BioARTS-Lab/Miniature_Microscope/Supporting Information/S6_Fig.tif

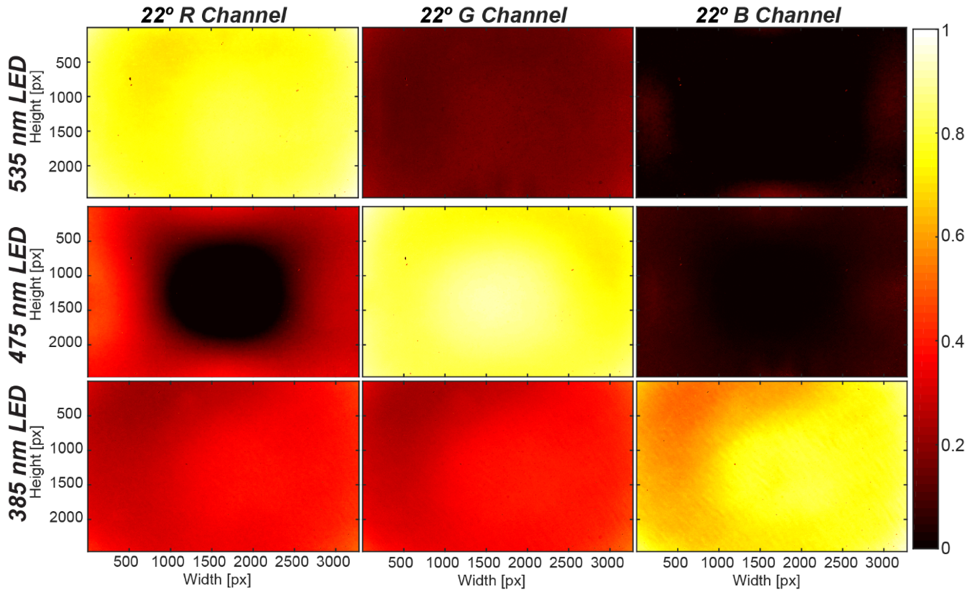
Supporting Information/S6_Fig.tif
