BioARTS-Lab/Miniature_Microscope/Supporting Information/S5_Fig.tif

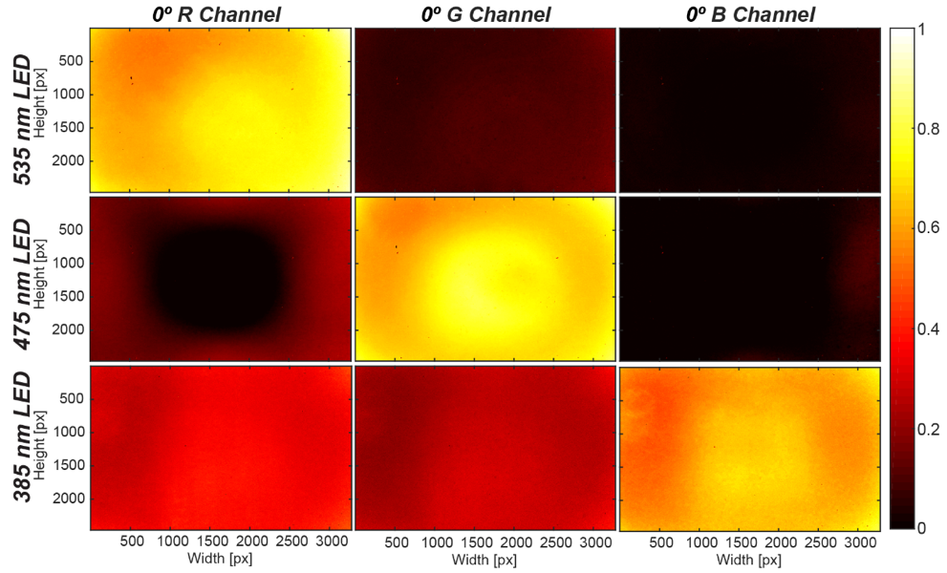
Supporting Information/S5_Fig.tif
