BioARTS-Lab/Miniature_Microscope/README.md

# Miniture_Microscope
3D-printed fluorescence miniature microscope
