BioARTS-Lab/Miniature_Microscope/GUI Python Script/start.gif

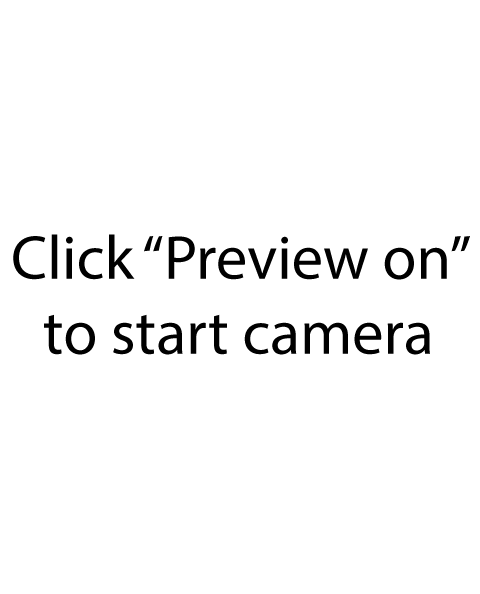
GUI Python Script/start.gif
