BioARTS-Lab/Miniature_Microscope/PCB Design Files - KiCAD/LEDs PCB.png

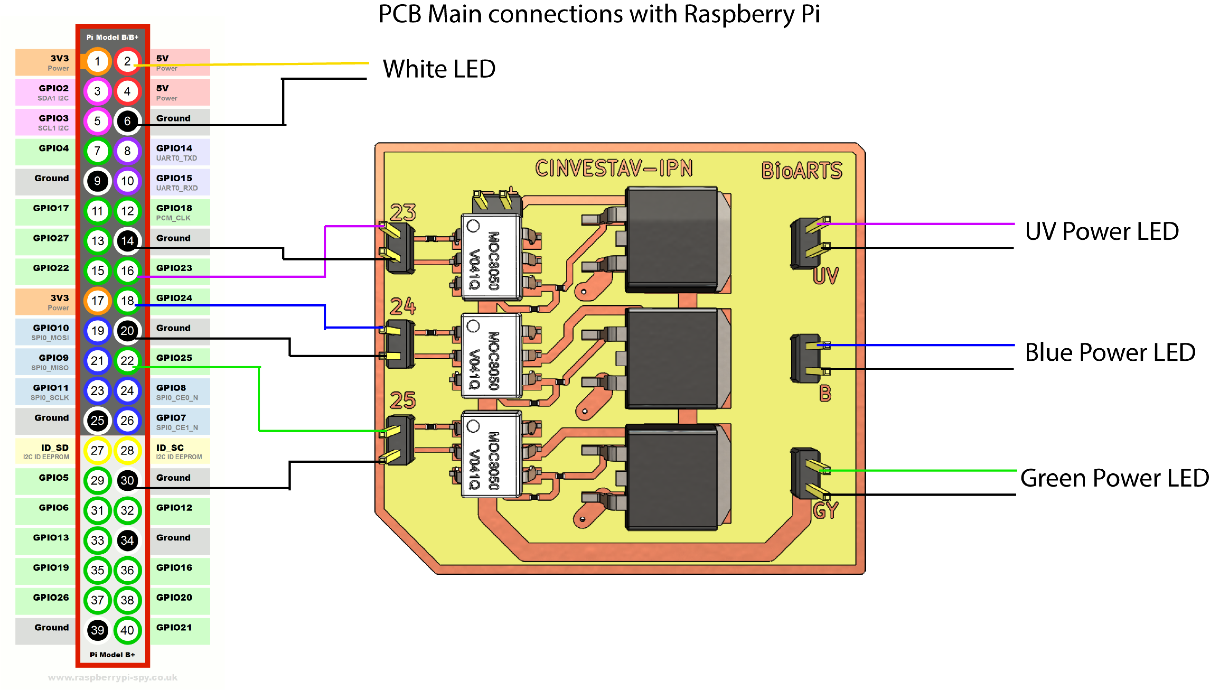
PCB Design Files - KiCAD/LEDs PCB.png
