BioARTS-Lab/Miniature_Microscope/Supporting Information/S1_Fig.tif

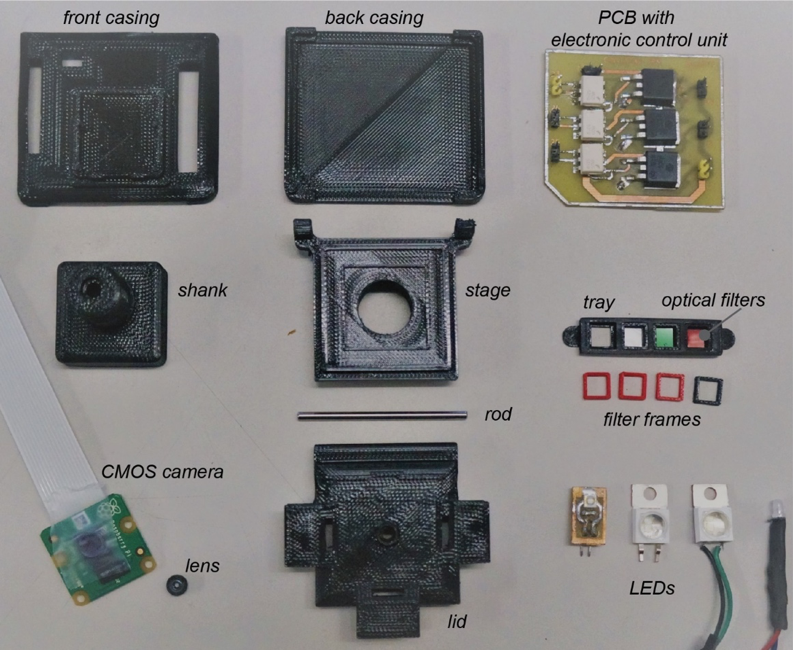
Supporting Information/S1_Fig.tif
