BioARTS-Lab/Miniature_Microscope/Supporting Information/S2_Fig.tif

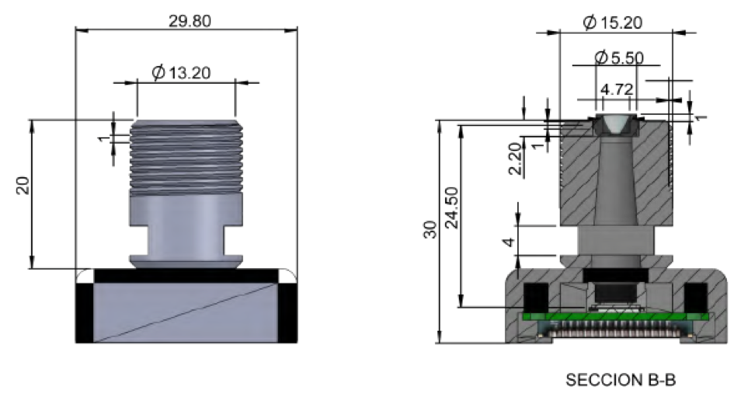
Supporting Information/S2_Fig.tif
