BioARTS-Lab/Miniature_Microscope/Supporting Information/S3_Fig.tif

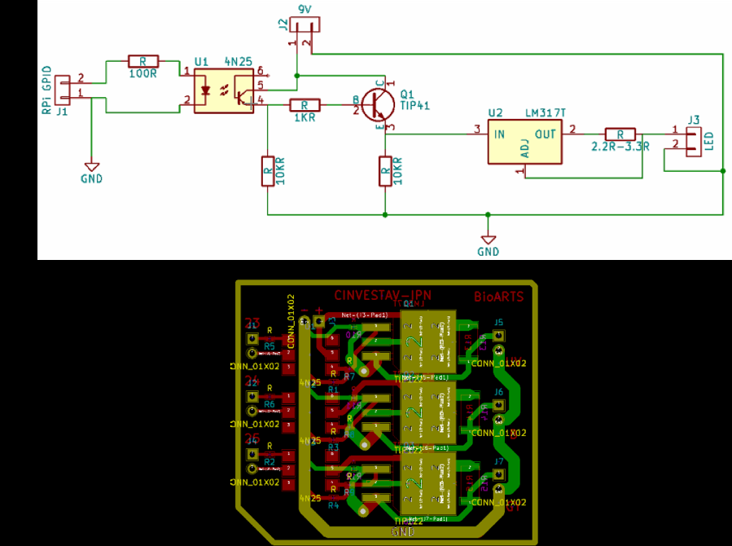
Supporting Information/S3_Fig.tif
