BioARTS-Lab/Miniature_Microscope/Supporting Information/S4_Fig.tif

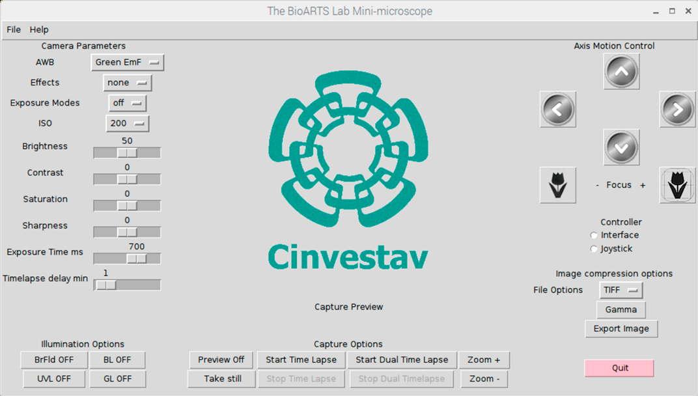
Supporting Information/S4_Fig.tif
