BioARTS-Lab/Miniature_Microscope/Supporting Information/S7_Fig.tif

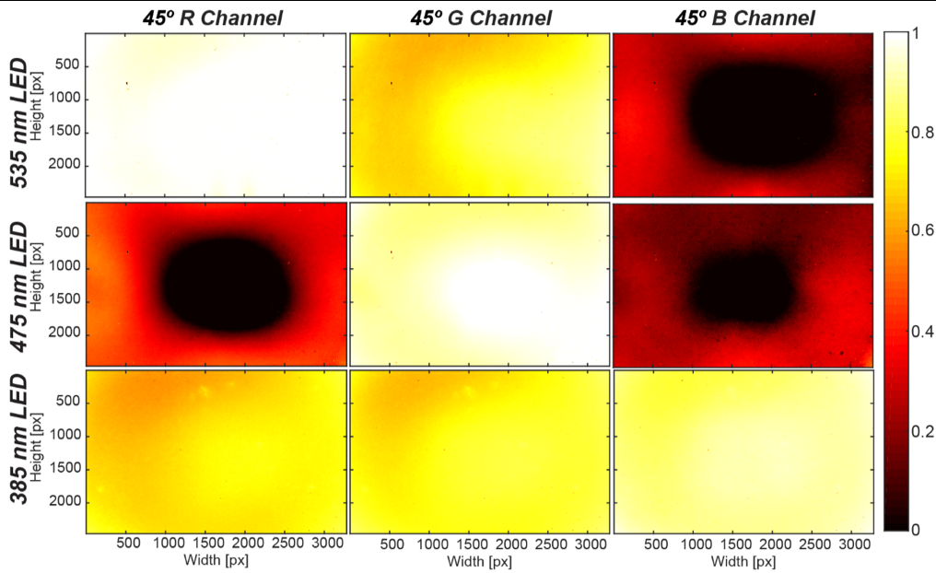
Supporting Information/S7_Fig.tif
