BioARTS-Lab/Miniature_Microscope/Supporting Information/S8_Fig.tif

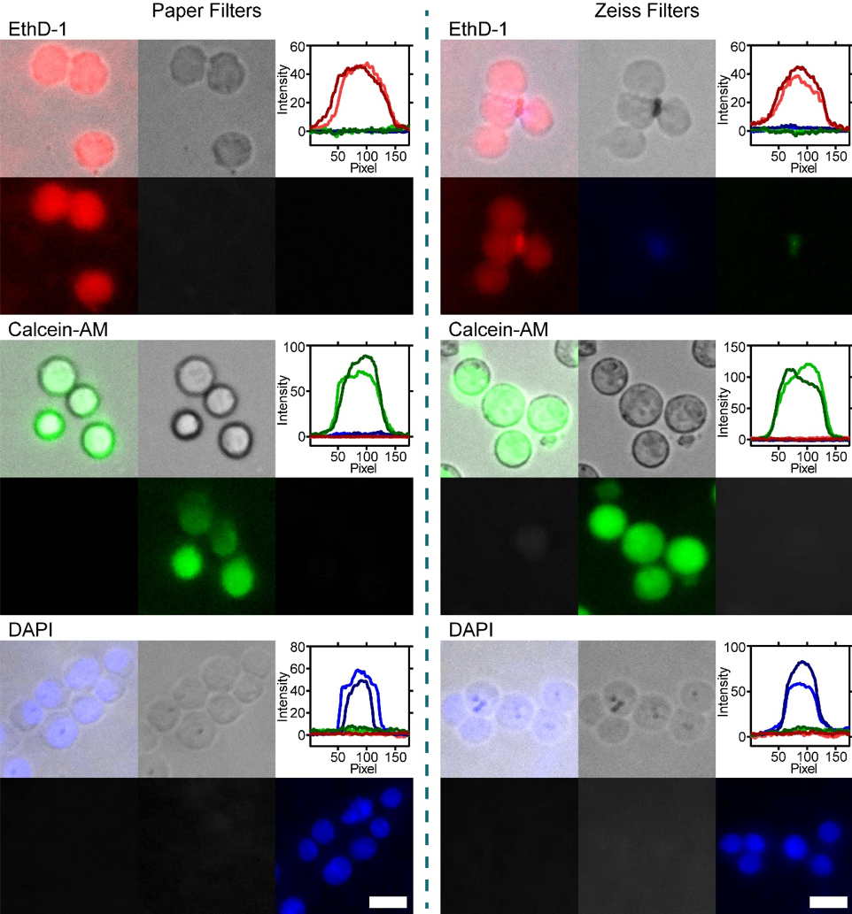
Supporting Information/S8_Fig.tif
