BioARTS-Lab/Miniature_Microscope/Supporting Information/S9_Fig.tif

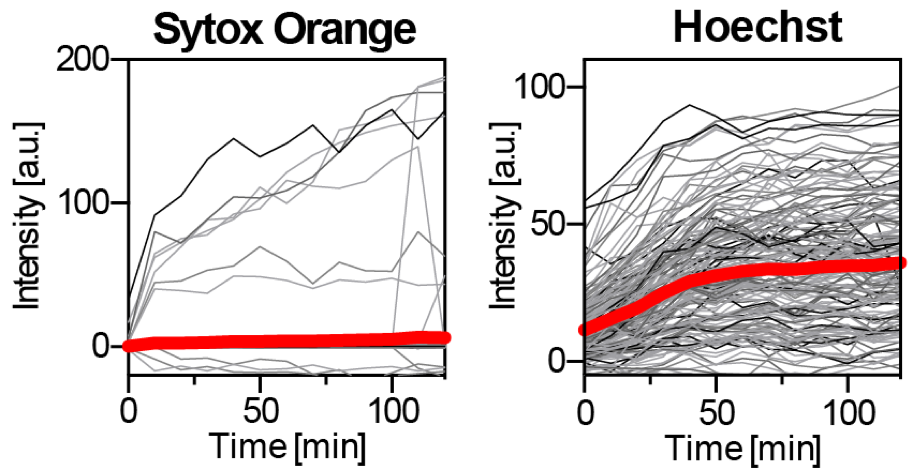
Supporting Information/S9_Fig.tif
