BioARTS-Lab/Miniature_Microscope/Supporting Information/S10_Fig.tif

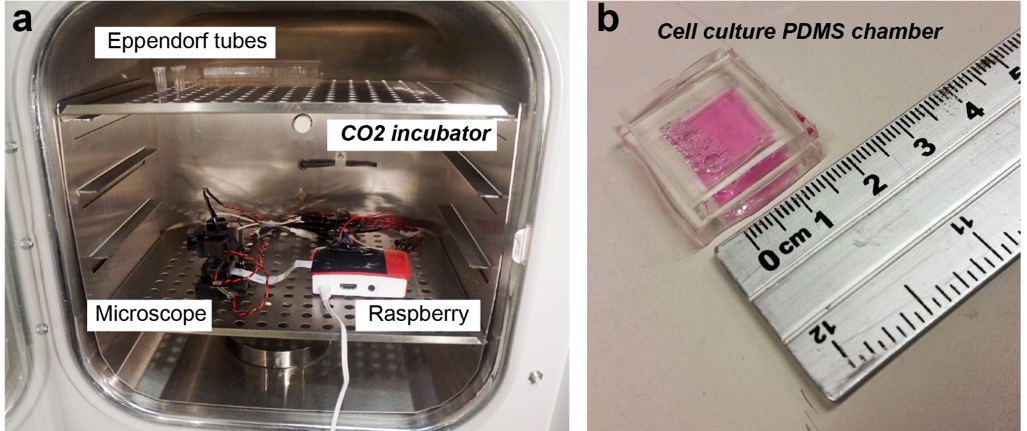
Supporting Information/S10_Fig.tif
