BioARTS-Lab/Miniature_Microscope/3D STL Files/LEDDrivePCB-Enclosure-CameraBase.STL

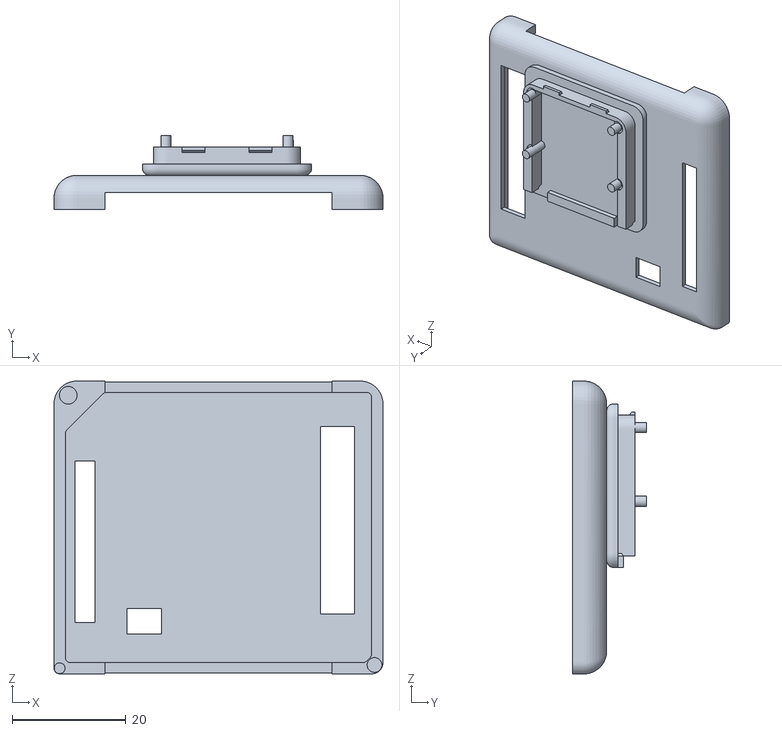
[picture p13: CAD file, 2019-08-25]
3D STL Files/LEDDrivePCB-Enclosure-CameraBase.STL
57.9 x 13.0 x 51.5
