BioARTS-Lab/Miniature_Microscope/PCB Design Files - KiCAD/LEDs PCB/LEDControlPCBSMDV2-Back Path_Cu.dxf

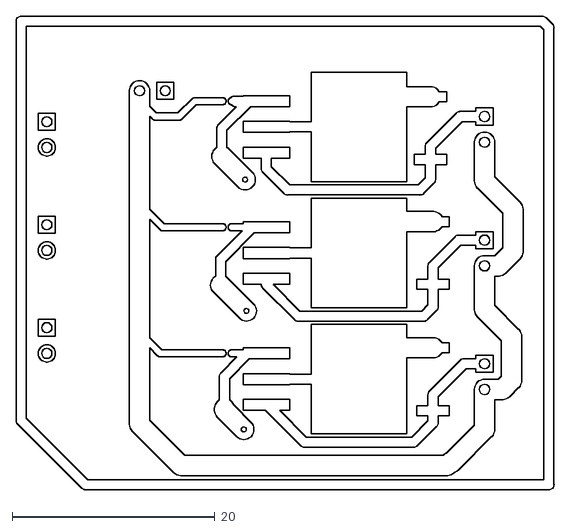
[picture p14: CAD file, 2019-08-25]
PCB Design Files - KiCAD/LEDs PCB/LEDControlPCBSMDV2-Back Path_Cu.dxf
53.1 x 46.7
