BioARTS-Lab/Miniature_Microscope/PCB Design Files - KiCAD/UV-LED PCB/UV LED PCB Layout-Front path_Cu.dxf

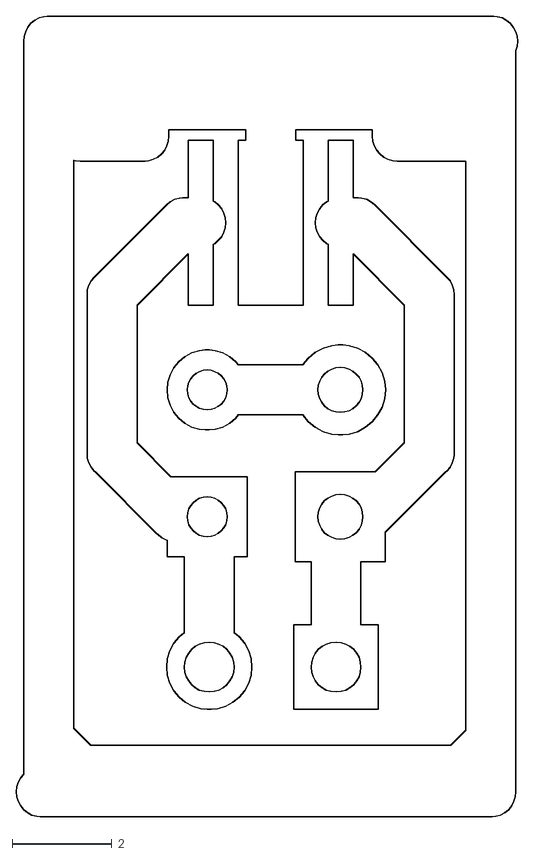
[picture p15: CAD file, 2019-08-25]
PCB Design Files - KiCAD/UV-LED PCB/UV LED PCB Layout-Front path_Cu.dxf
10.0 x 16.0
