BioARTS-Lab/Miniature_Microscope/3D STL Files/LEDDrivePCB-Base.STL

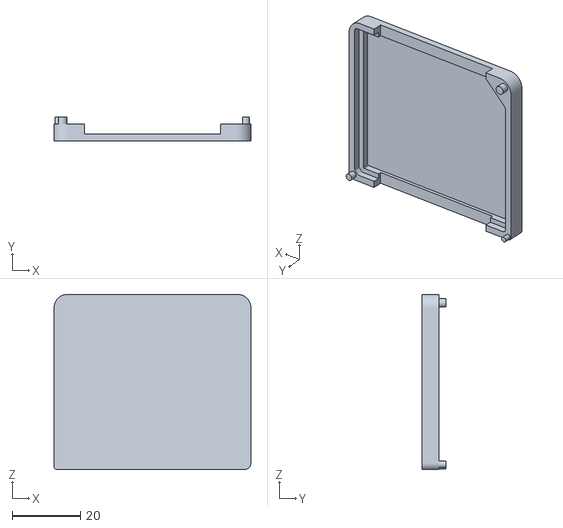
[picture p16: CAD file, 2019-08-25]
3D STL Files/LEDDrivePCB-Base.STL
57.9 x 7.00 x 51.5
