BioARTS-Lab/Miniature_Microscope/PCB Design Files - KiCAD/LEDs PCB/LEDControlPCBSMDV2-Back Path_CuMirror.dxf

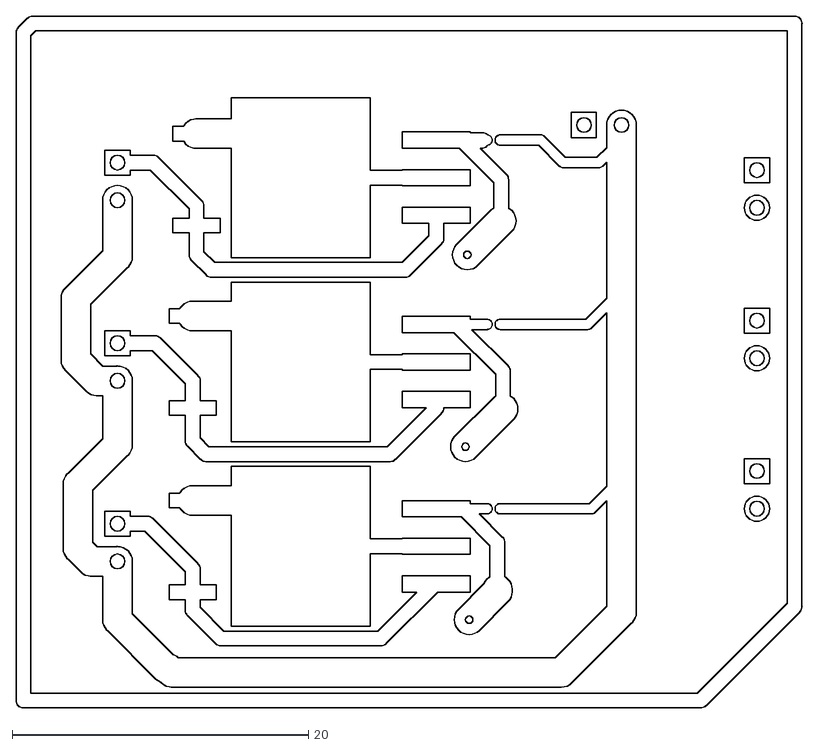
[picture p17: CAD file, 2019-08-25]
PCB Design Files - KiCAD/LEDs PCB/LEDControlPCBSMDV2-Back Path_CuMirror.dxf
53.1 x 46.7
