BioARTS-Lab/Miniature_Microscope/PCB Design Files - KiCAD/UV-LED PCB/solderLED-Footprint.DXF

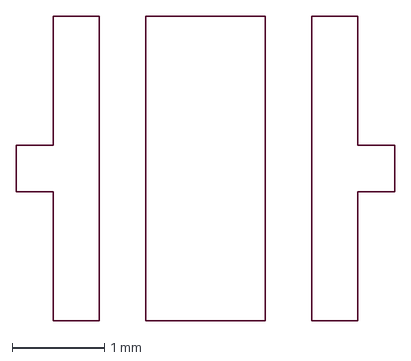
[picture p18: CAD file, 2019-08-25]
PCB Design Files - KiCAD/UV-LED PCB/solderLED-Footprint.DXF
4.10 x 3.30 mm
