BioARTS-Lab/Miniature_Microscope/3D STL Files/Plate.STL

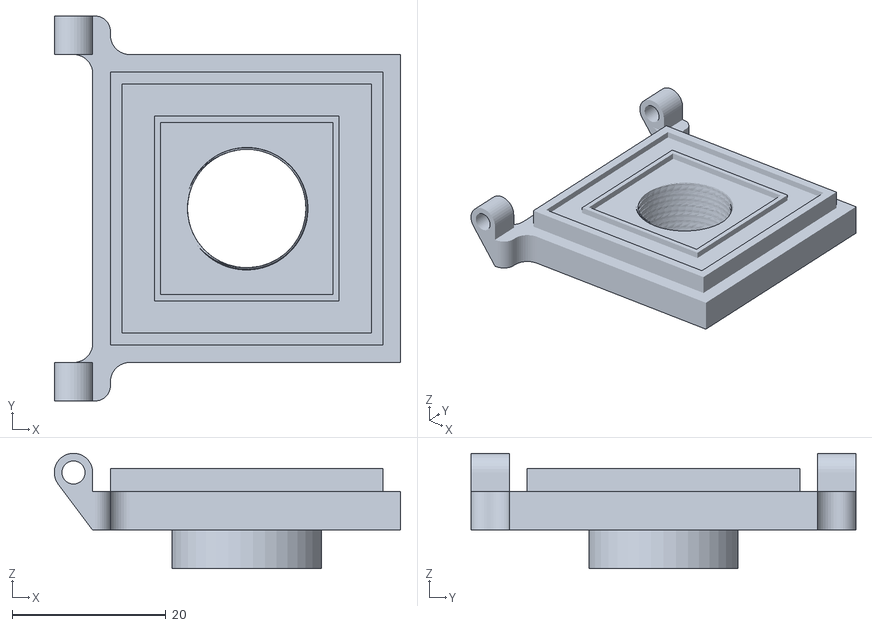
[picture p19: CAD file, 2019-08-25]
3D STL Files/Plate.STL
45.0 x 50.0 x 15.0
