BioARTS-Lab/Miniature_Microscope/PCB Design Files - KiCAD/LEDs PCB/LEDControlPCBSMDV2-Front paths_Cu.dxf

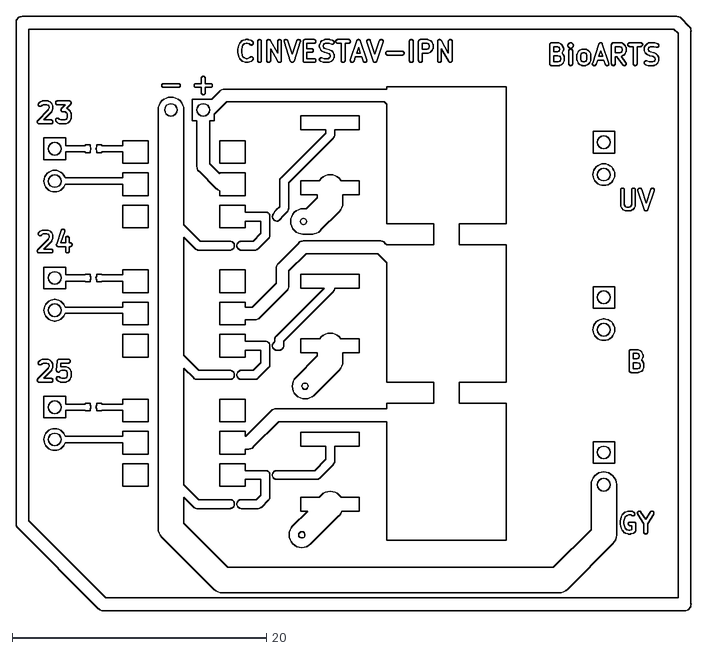
[picture p20: CAD file, 2019-08-25]
PCB Design Files - KiCAD/LEDs PCB/LEDControlPCBSMDV2-Front paths_Cu.dxf
53.1 x 46.7
