BioARTS-Lab/Miniature_Microscope/PCB Design Files - KiCAD/UV-LED PCB/UV LED PCB Layout-Back Path_Cu.dxf

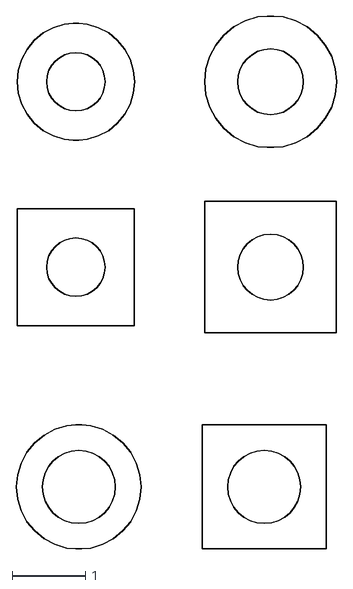
[picture p21: CAD file, 2019-08-25]
PCB Design Files - KiCAD/UV-LED PCB/UV LED PCB Layout-Back Path_Cu.dxf
4.38 x 7.30
