BioARTS-Lab/Miniature_Microscope/3D STL Files/PlateEnclosure.STL

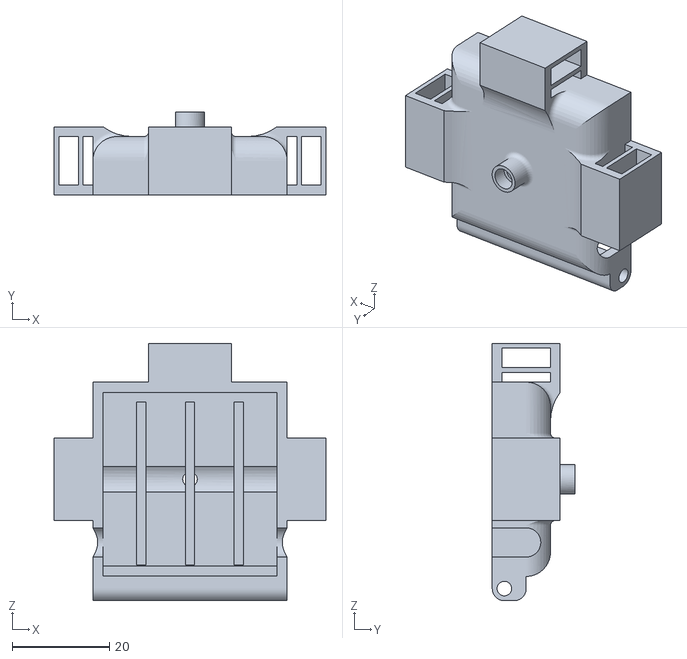
[picture p22: CAD file, 2019-08-25]
3D STL Files/PlateEnclosure.STL
56.0 x 17.0 x 53.0
