BioARTS-Lab/Miniature_Microscope/3D STL Files/FilterSlider.STL

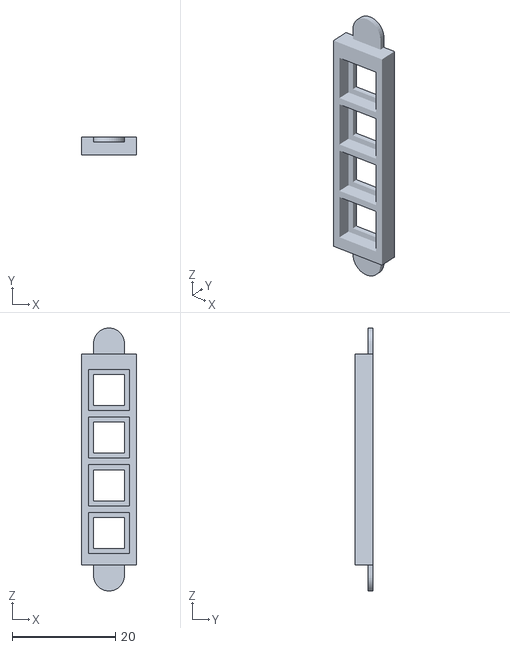
[picture p23: CAD file, 2019-08-25]
3D STL Files/FilterSlider.STL
10.6 x 3.50 x 51.0
