BioARTS-Lab/Miniature_Microscope/3D STL Files/FilterHolder.STL

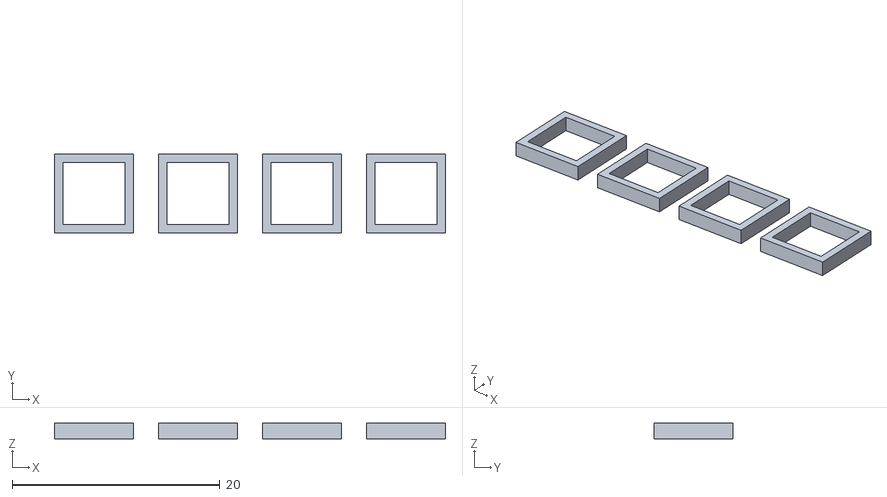
[picture p24: CAD file, 2019-08-25]
3D STL Files/FilterHolder.STL
37.6 x 7.60 x 1.50
