BioARTS-Lab/Miniature_Microscope/3D STL Files/ObjectiveForFilterSlider.STL

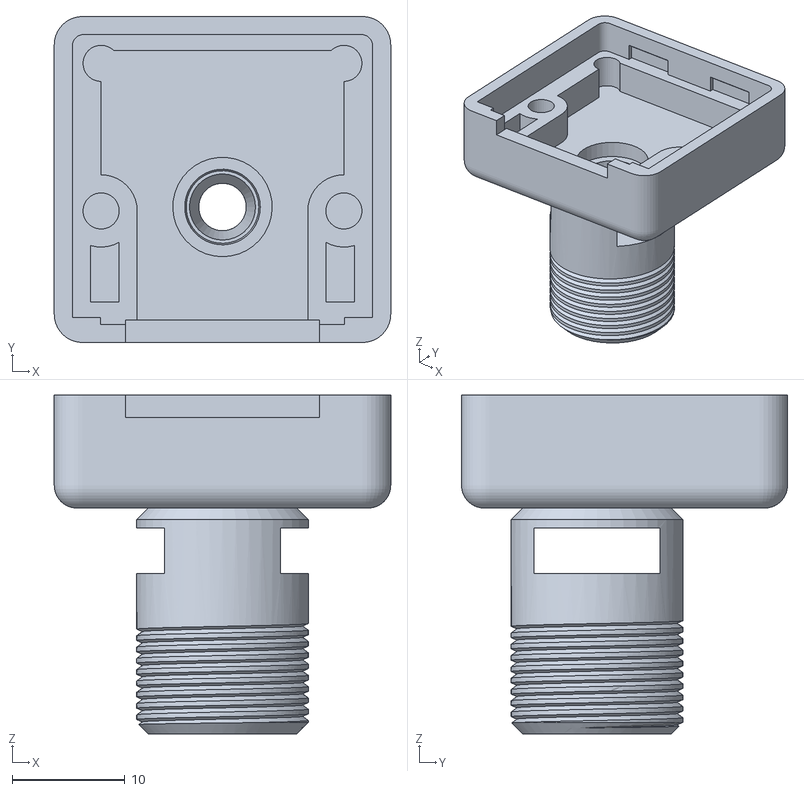
[picture p26: CAD file, 2019-08-25]
3D STL Files/ObjectiveForFilterSlider.STL
29.8 x 28.9 x 30.0
