BioARTS-Lab/Miniature_Microscope/3D STL Files/LEDenclosure.STL

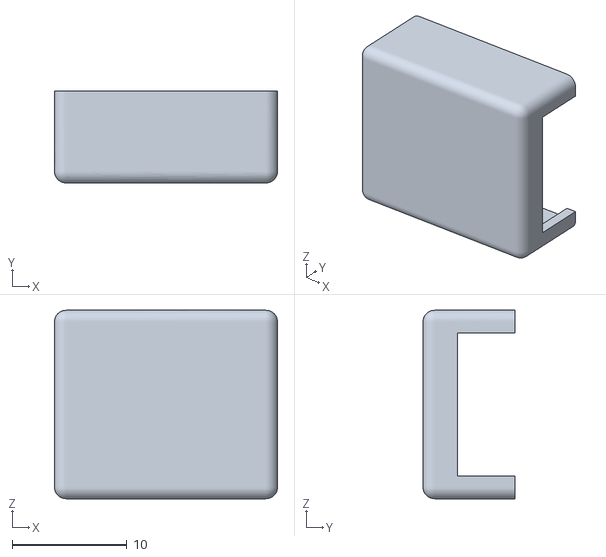
[picture p27: CAD file, 2019-08-25]
3D STL Files/LEDenclosure.STL
19.4 x 8.00 x 16.4
