BioARTS-Lab/Miniature_Microscope/PCB Design Files - KiCAD/LEDs PCB/LEDControlPCBSMDV2.kicad_pcb

## KiCad design PCB Design Files - KiCAD/LEDs PCB/LEDControlPCBSMDV2.kicad_pcb (2019-08-25)

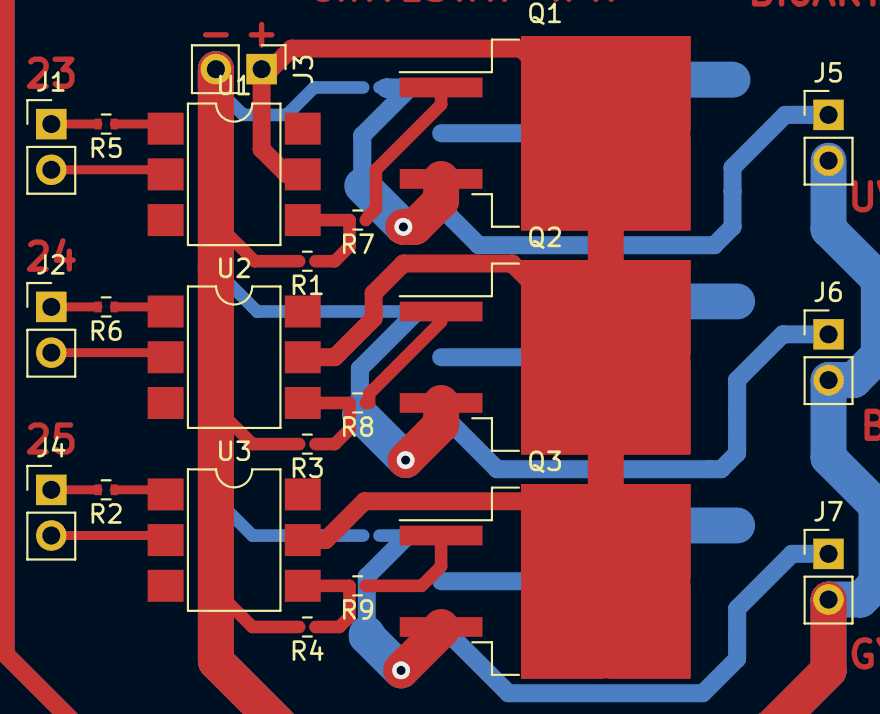
[picture p28: board LEDControlPCBSMDV2.kicad_pcb from above]

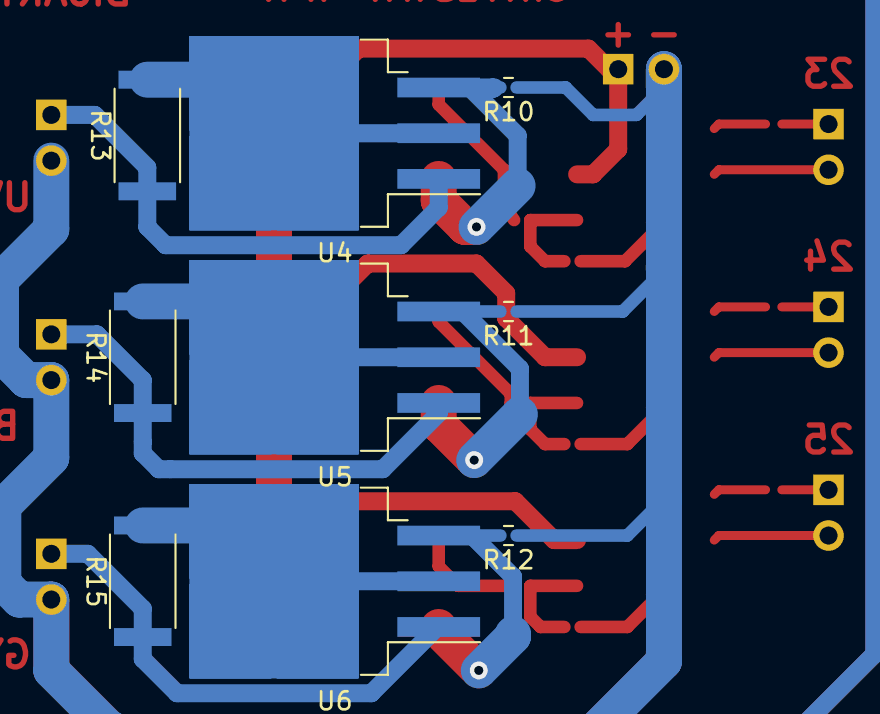
[picture p29: board LEDControlPCBSMDV2.kicad_pcb from below]

Board: 2 copper layers, 31 parts (9 on the bottom side), 26 nets.

Parts:
J1, J2, J3, J4, J5, J6, J7: CONN_01X02; Pin_Header_Straight_1x02_Pitch2.54mm
Q1, Q2, Q3: TIP122; TO-263-2
R1, R2, R3, R4, R5, R6, R7, R8, R9, R10, R11, R12: R; R_0402
R13, R14, R15: R; R_2512
U1, U2, U3: 4N25; DIP-6_W7.62mm_SMD
U4, U5, U6: LM317T; TO-263-3_TabPin2

Connections:
GND: J3.2, J5.2, J6.2, J7.2, R1.2, R3.2, R4.2, R10.1, R11.1, R12.1
unnamed: J1.1, R5.2
unnamed: J1.2, U1.2
unnamed: J2.1, R6.2
unnamed: J2.2, U2.2
unnamed: J3.1, Q1.2, Q2.2, Q3.2, U1.5, U2.5, U3.5
unnamed: J4.1, R2.2
unnamed: J4.2, U3.2
unnamed: J5.1, R13.1, U4.1
unnamed: J6.1, R14.1, U5.1
unnamed: J7.1, R15.1, U6.1
unnamed: Q1.1, R7.1
unnamed: Q1.3, R10.2, U4.3
unnamed: Q2.1, R8.1
unnamed: Q2.3, R11.2, U5.3
unnamed: Q3.1, R9.1
unnamed: Q3.3, R12.2, U6.3
unnamed: R1.1, R7.2, U1.4
unnamed: R2.1, U3.1
unnamed: R3.1, R8.2, U2.4
unnamed: R4.1, R9.2, U3.4
unnamed: R5.1, U1.1
unnamed: R6.1, U2.1
unnamed: R13.2, U4.2
unnamed: R14.2, U5.2
unnamed: R15.2, U6.2
