BioARTS-Lab/Miniature_Microscope/PCB Design Files - KiCAD/UV-LED PCB/UV LED PCB Layout.kicad_pcb

## KiCad design PCB Design Files - KiCAD/UV-LED PCB/UV LED PCB Layout.kicad_pcb (2019-08-25)

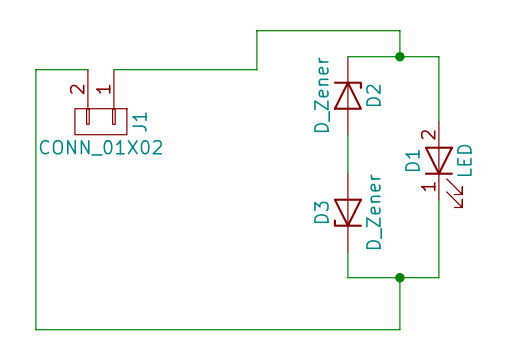
[picture p30: schematic UV-LED.sch]

Parts:
D1: LED; VLMU3500
D2, D3: D_Zener; D_A-405_P2.54mm_Vertical_KathodeUp
J1: CONN_01X02; Pin_Header_Angled_1x02_Pitch2.54mm

Connections:
unnamed: D1.1 (K), D3.1 (K), J1.2
unnamed: D1.2 (A), D2.1 (K), J1.1
unnamed: D2.2 (A), D3.2 (A)

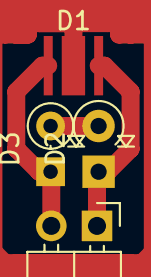
[picture p31: board UV LED PCB Layout.kicad_pcb from above]

Board: 2 copper layers, 4 parts (0 on the bottom side), 3 nets.
